Saph123/Pouleporte/PCB/PP.kicad_pcb

## KiCad design PCB/PP.kicad_pcb (2022-12-21)

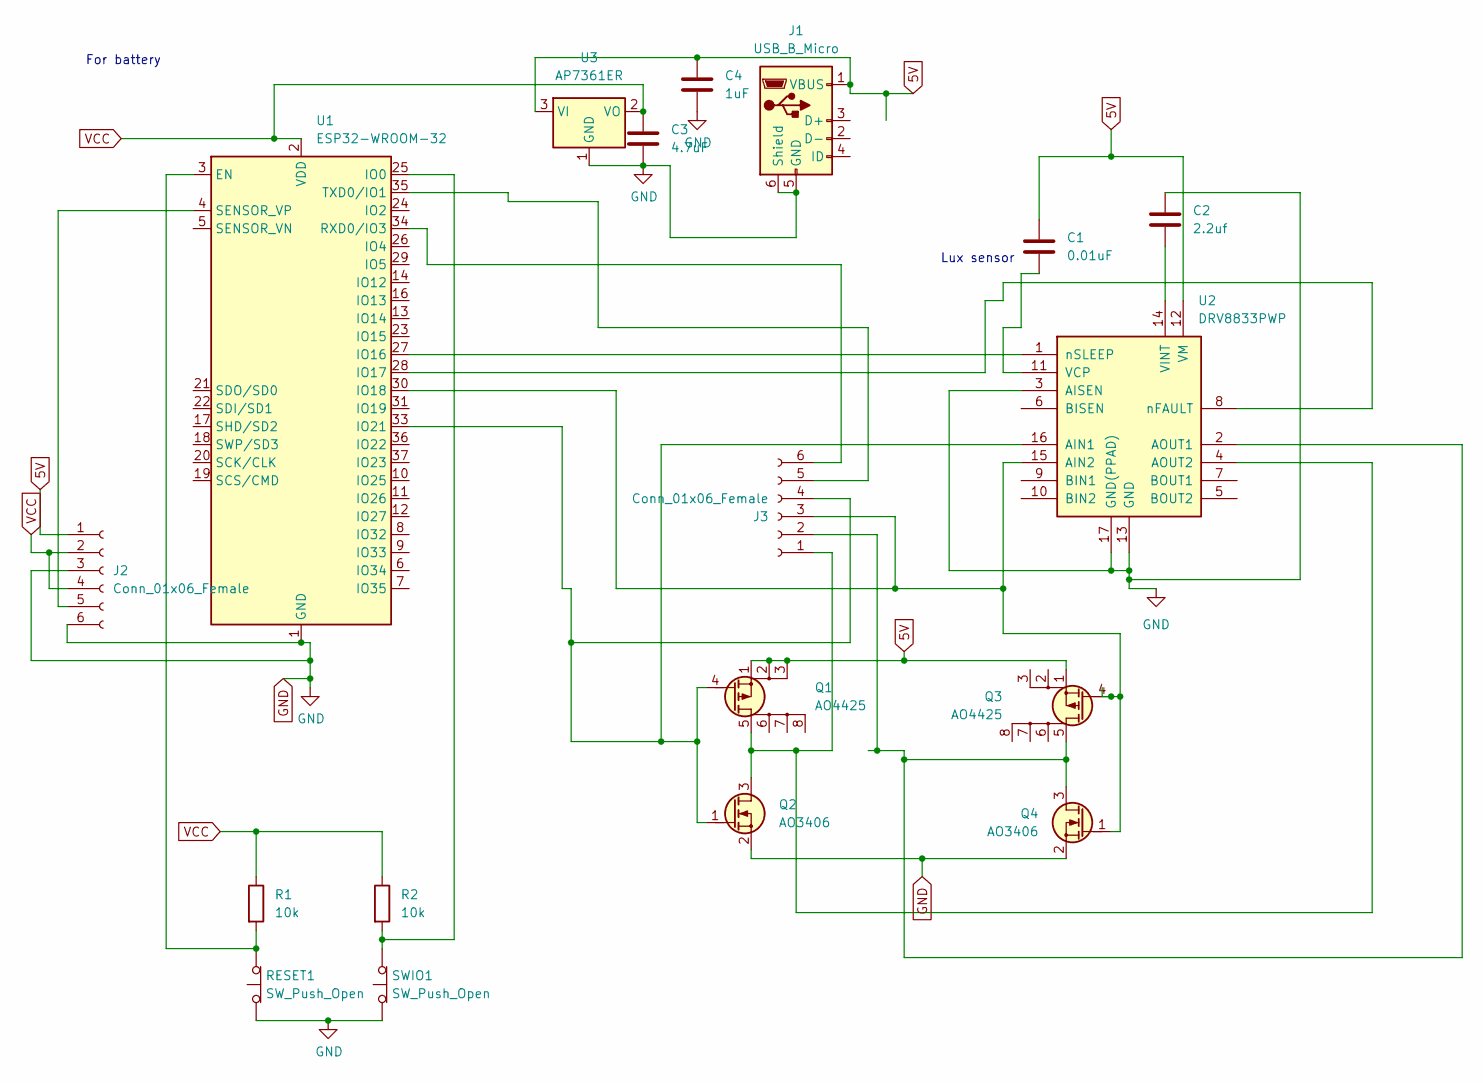
[picture p1: schematic PP.kicad_sch]

Parts:
C1: 0.01uF; C_0603_1608Metric
C2: 2.2uf; C_0603_1608Metric
C3: 4.7uF; C_0603_1608Metric
C4: 1uF; C_0603_1608Metric
J1: USB_B_Micro; USB_aliexpress
J2, J3: Conn_01x06_Female; TerminalBlock_Phoenix_MKDS-1,5-6_1x06_P5.00mm_Horizontal
Q1, Q3: AO4425; SO-8_3.9x4.9mm_P1.27mm
Q2, Q4: AO3406; SOT-23
R1, R2: 10k; C_0603_1608Metric
RESET1: SW_Push_Open; interrupteur
SWIO1: SW_Push_Open; interrupteur
U1: ESP32-WROOM-32
U2: DRV8833PWP; HTSSOP-16-1EP_4.4x5mm_P0.65mm_EP3.4x5mm_Mask2.46x2.31mm_The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
U3: AP7361ER; SOT-223-3_TabPin2

Connections:
5V: C1.1, C4.1, J1.1 (VBUS), J2.1, Q1.1 (S), Q1.2 (S), Q1.3 (S), Q3.1 (S), U2.12 (VM), U3.3 (VI)
GND: C2.1, C3.2, C4.2, J1.5 (GND), J1.6 (Shield), J2.3, J2.6, Q2.2 (S), Q4.2 (S), RESET1.1 (A), SWIO1.1 (A), U1.1 (GND), U1.15 (GND), U1.38 (GND), U1.39 (GND), U2.3 (AISEN), U2.13 (GND), U2.17 (GND(PPAD)), U3.1 (GND)
unnamed: C1.2, U2.11 (VCP)
unnamed: C2.2, U2.14 (VINT)
unnamed: J3.4, Q1.4 (G), Q2.1 (G), U1.33 (IO21), U2.16 (AIN1)
unnamed: J3.1, Q1.5 (D), Q2.3 (D), U2.4 (AOUT2)
unnamed: J3.3, Q3.4 (G), Q4.1 (G), U1.30 (IO18), U2.15 (AIN2)
unnamed: J3.2, Q3.5 (D), Q4.3 (D), U2.2 (AOUT1)
unnamed: R1.2, RESET1.2 (B), U1.3 (EN)
unnamed: R2.2, SWIO1.2 (B), U1.25 (IO0)
unnamed: J2.5, U1.4 (SENSOR_VP)
unnamed: U1.27 (IO16), U2.1 (nSLEEP)
unnamed: U1.28 (IO17), U2.8 (nFAULT)
unnamed: J3.6, U1.34 (RXD0/IO3)
unnamed: J3.5, U1.35 (TXD0/IO1)
VCC: C3.1, J2.2, J2.4, R1.1, R2.1, U1.2 (VDD), U3.2 (VO)

Notes on the sheet:
Lux sensor
For battery

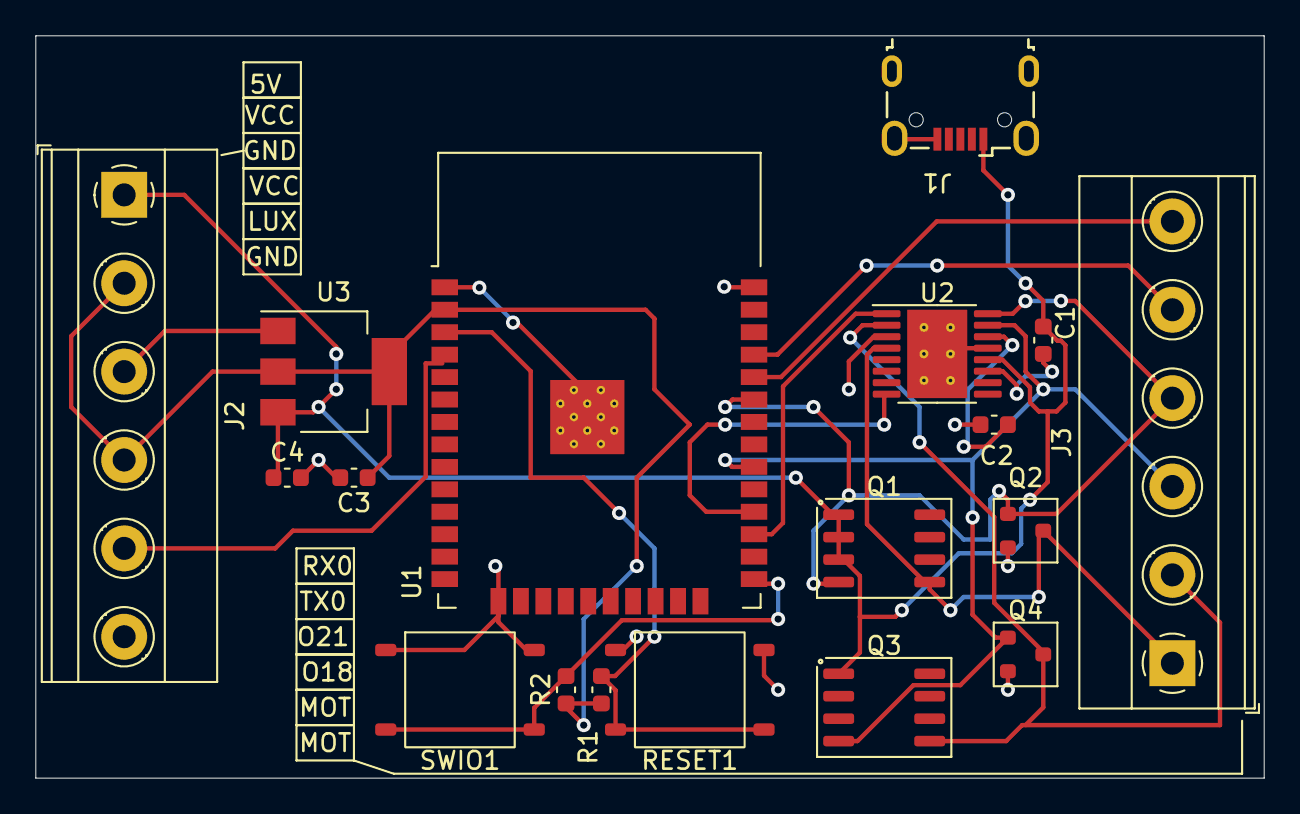
[picture p2: board PP.kicad_pcb from above]

Board: 2 copper layers, 69.5 x 42.0 mm, 18 parts (0 on the bottom side), 16 nets.
