Saph123/Pouleporte/(commit log)

2019-04-23 Adding the first draft of PCB
    [PP.kicad_pcb, PP.sch, _saved_PP.sch]
2019-04-23 Added a footprint for devkit v1
2019-05-21 Adding a LED to GPIO 5
2019-05-21 Not tested: added val sensor1 when door closed
2019-05-21 Tested, seems to work Needs to be done: stop motor when door is detected!
2019-05-23 added motor.h and motor.cpp
2019-06-11 change in print filter avant ouverture/fermeture phrase
2019-06-11 added door state in print
2019-06-11 correction on println
2019-06-11 not finish yet but creating sensor hpp
2019-06-11 try to fix hpp
    [motor.hpp, sensor_presence.cpp]
2019-06-11 not finished yet the motor.cpp yet need the door open status
2019-06-26 new sensor to ADC2 ch2 pin D4/D2
2019-06-26 all correct I think... needs to be tested now
    [main.cpp, motor.hpp, sensor_presence.cpp]
2019-06-26 ESP_BT print quand les etats de la porte sont chelou
2019-06-27 avec les bons pinout du terrain!!
2019-07-01 code installed on 01/07/2019 sensors disabled
2019-07-09 new pcb! V1
    [PP-B_Cu.gbr, PP-B_Mask.gbr, PP-B_Paste.gbr, PP-B_SilkS.gbr, PP-Edge_Cuts.gbr, PP-F_Cu.gbr, PP-F_Mask.gbr, PP-F_Paste.gbr]
2019-12-09 store firsttime in nvs store jour in nvs remove useless stuff with sensors
2021-10-22 adding moving average'
    [PP-F_Mask.gbr]
2022-04-24 Updated main cpp with 2 tempo, and fixed mean avg, installed on 24/04é
    [main.cpp]
2022-12-05 Update pouleporte releaseV2
    [PP-B_Cu.gbr, PP-B_Mask.gbr, PP-B_Paste.gbr, PP-B_SilkS.gbr, PP-Edge_Cuts.gbr, PP-F_Cu.gbr, PP-F_Mask.gbr, PP-F_Paste.gbr]
2022-12-08 adding all files in doubt
    [PP.kicad_sch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]
2022-12-21 adding usb and ap7361 libs
    [PP.kicad_pcb, PP.kicad_sch]
2022-12-21 Update schematic & pcb v3
    [PP.kicad_pcb, PP.kicad_sch]
2022-12-21 Gerber for V3
    [PP-B_Cu.gbr, PP-B_Mask.gbr, PP-B_Paste.gbr, PP-B_Silkscreen.gbr, PP-Edge_Cuts.gbr, PP-F_Cu.gbr, PP-F_Mask.gbr, PP-F_Paste.gbr]
